darkomen/ESP12-pcb/ESP12_pcb.kicad_pcb

## KiCad design ESP12_pcb.kicad_pcb (2017-10-11)

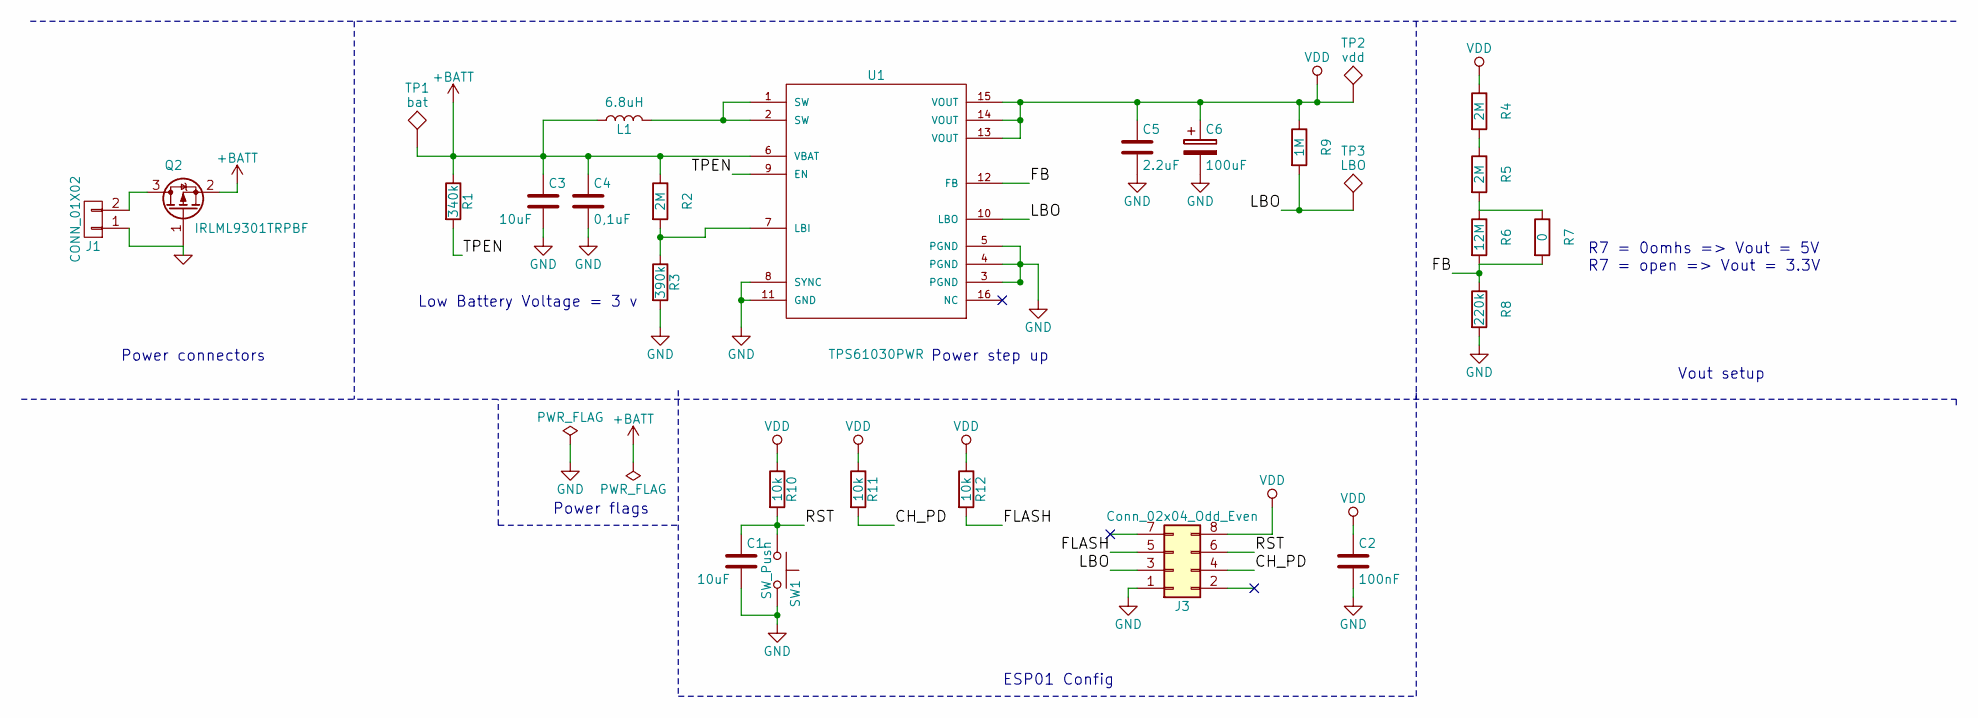
[picture p1: schematic ESP12_pcb.sch, Tpg Button]

Parts:
C1, C3: 10uF; C_0603_HandSoldering
C2: 100nF; C_0603_HandSoldering
C4: 0,1uF; C_0603_HandSoldering
C5: 2.2uF; C_0603_HandSoldering
C6: 100uF; smd_5_5.4
J1: CONN_01X02; Pin_Header_Straight_1x02_Pitch2.54mm
J3: Conn_02x04_Odd_Even; Pin_Header_Straight_2x04_Pitch2.54mm
L1: 6.8uH; smd_L_4532
Q2: IRLML9301TRPBF; SOT-23
R1: 340k; R_0603_HandSoldering
R2, R4, R5: 2M; R_0603_HandSoldering
R3: 390k; R_0603_HandSoldering
R6: 12M; R_0603_HandSoldering
R7: 0; R_0603_HandSoldering
R8: 220k; R_0603_HandSoldering
R9: 1M; R_0603_HandSoldering
R10, R11, R12: 10k; R_0603_HandSoldering
SW1: SW_Push; button_4pin
TP1: bat; Measurement_Point_Round-SMD-Pad_Small
TP2: vdd; Measurement_Point_Round-SMD-Pad_Small
TP3: LBO; Measurement_Point_Round-SMD-Pad_Small
U1: TPS61030PWR; R-PDSO-16

Connections:
+BATT: C3.1, C4.1, L1.1, Q2.2 (S), R1.1, R2.1, TP1.1, U1.6 (VBAT)
/CH_PD: J3.4, R11.2
/FB: R6.2, R7.2, R8.1, U1.12 (FB)
/FLASH: J3.5, R12.2
/LBO: J3.3, R9.2, TP3.1, U1.10 (LBO)
/RST: C1.1, J3.6, R10.2, SW1.1
/TPEN: R1.2, U1.9 (EN)
GND: C1.2, C2.2, C3.2, C4.2, C5.2, C6.2, J1.1, J3.1, Q2.1 (G), R3.2, R8.2, SW1.2, U1.3 (PGND), U1.4 (PGND), U1.5 (PGND), U1.8 (SYNC), U1.11 (GND)
unnamed: J1.2, Q2.3 (D)
unnamed: L1.2, U1.1 (SW), U1.2 (SW)
unnamed: R2.2, R3.1, U1.7 (LBI)
unnamed: R4.2, R5.1
unnamed: R5.2, R6.1, R7.1
VDD: C2.1, C5.1, C6.1, J3.8, R4.1, R9.1, R10.1, R11.1, R12.1, TP2.1, U1.13 (VOUT), U1.14 (VOUT), U1.15 (VOUT)

Notes on the sheet:
Low Battery Voltage = 3 v
Power connectors
Power step up
Power flags
R7 = 0omhs => Vout = 5V R7 = open => Vout = 3.3V
Vout setup
ESP01 Config

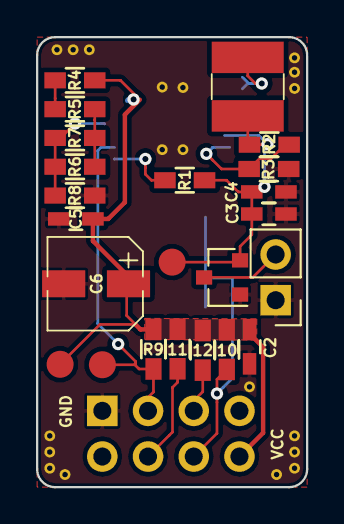
[picture p2: board ESP12_pcb.kicad_pcb from above]

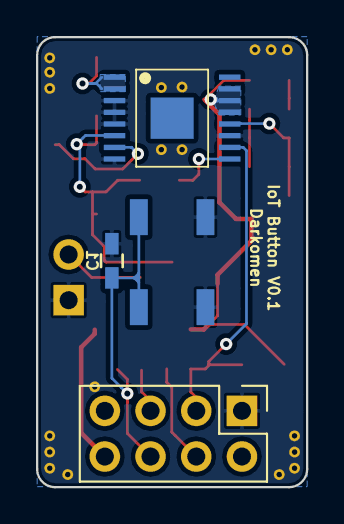
[picture p3: board ESP12_pcb.kicad_pcb from below]

Board: 2 copper layers, 15.0 x 25.0 mm, 27 parts (4 on the bottom side), 14 nets.
