darkomen/ESP12-pcb/(commit log)

2017-08-17 Finished power components
    [ESP12_pcb.kicad_pcb, ESP12_pcb.sch]
2017-08-17 Gerber files has been generated
    [ESP12_pcb-B.Cu.gbl, ESP12_pcb-B.SilkS.gbo, ESP12_pcb-Edge.Cuts.gm1, ESP12_pcb-F.Cu.gtl, ESP12_pcb-F.SilkS.gto, ESP12_pcb.drl]
2017-08-18 Modified Top silk screen
    [ESP12_pcb.kicad_pcb, ESP12_pcb.sch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]
2017-08-18 Gerber files updated
    [ESP12_pcb-B.Mask.gbs, ESP12_pcb-F.Mask.gts]
2017-08-21 Changed one connection for AP2112k
    [ESP12_pcb.kicad_pcb, ESP12_pcb.sch]
2017-08-21 BOM file generated
    [bom.xlsx]
2017-10-11 Version V0.1 sended to fabrication
    [ESP12_pcb-B.Cu.gbl, ESP12_pcb-B.Mask.gbs, ESP12_pcb-B.SilkS.gbo, ESP12_pcb-Edge.Cuts.gm1, ESP12_pcb-F.Cu.gtl, ESP12_pcb-F.Mask.gts, ESP12_pcb-F.SilkS.gto, ESP12_pcb.drl]
